stosifian/shoggoth-mini-bringup/media/mirror_demo.gif

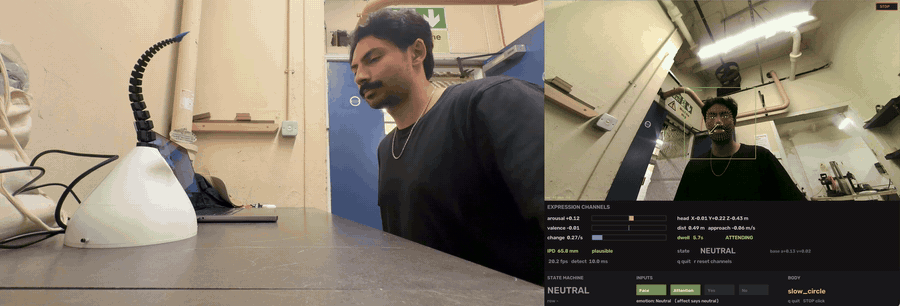
media/mirror_demo.gif
