stosifian/shoggoth-mini-bringup/assets/hardware/printing/roller_single_test.3mf

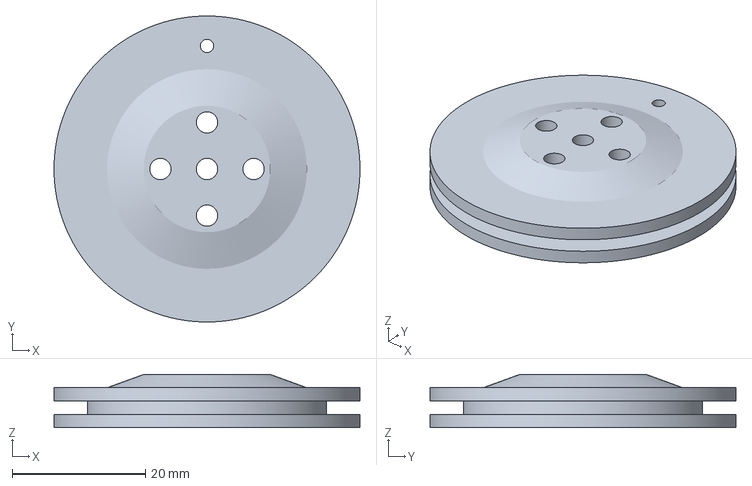
[picture p24: CAD file, 2026-08-24]
assets/hardware/printing/roller_single_test.3mf
46.0 x 46.0 x 8.00 mm
