stosifian/shoggoth-mini-bringup/assets/hardware/printing/tips.3mf

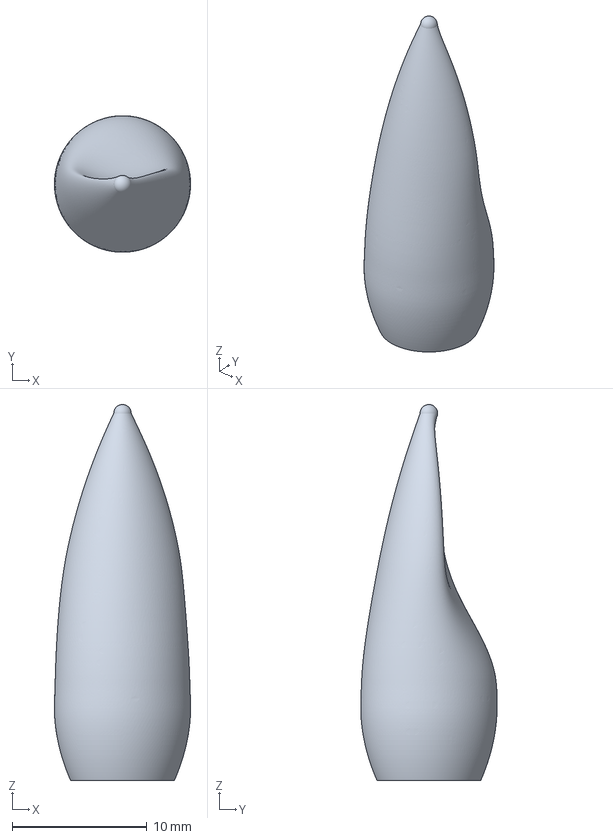
[picture p25: CAD file, 2026-08-24]
assets/hardware/printing/tips.3mf
10.1 x 10.1 x 27.9 mm
