stosifian/shoggoth-mini-bringup/assets/hardware/printing/dome_mod.step

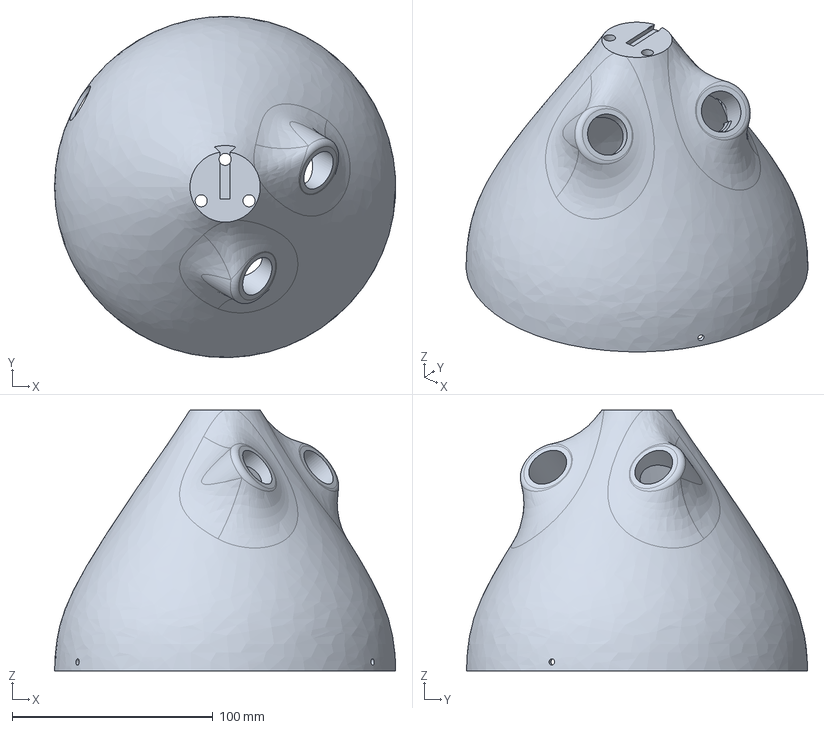
[picture p26: CAD file, 2026-08-24]
assets/hardware/printing/dome_mod.step
169.9 x 169.9 x 130.0 mm
