stosifian/shoggoth-mini-bringup/assets/hardware/printing/dome_mod_test.3mf

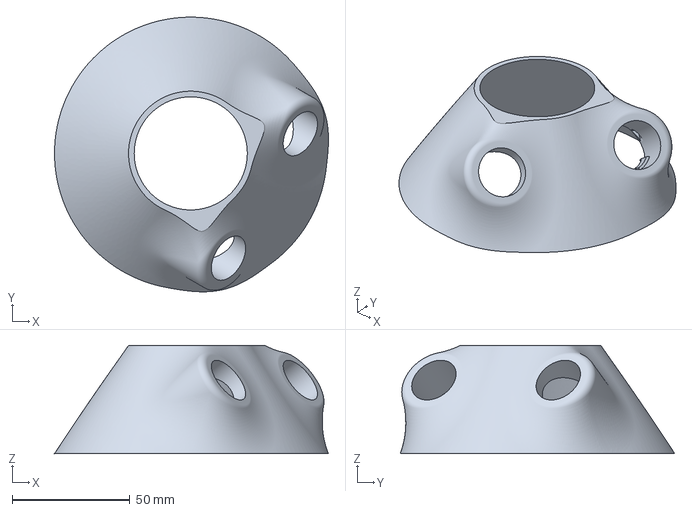
[picture p27: CAD file, 2026-08-24]
assets/hardware/printing/dome_mod_test.3mf
116.3 x 116.6 x 46.0 mm
