stosifian/shoggoth-mini-bringup/assets/hardware/printing/roller_cover_roller_tip_all.3mf

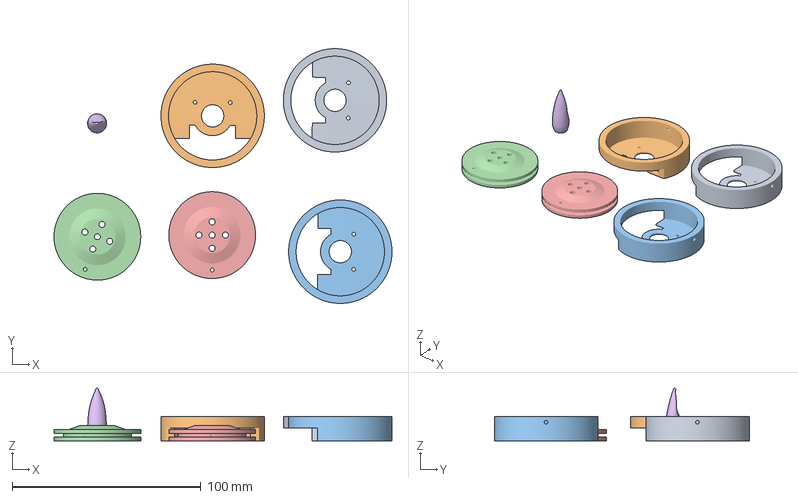
[picture p28: CAD file, 2026-08-24]
assets/hardware/printing/roller_cover_roller_tip_all.3mf
179.2 x 135.0 x 27.9 mm
roller_cover.step x 3
roller.step x 2
spike.step
