stosifian/shoggoth-mini-bringup/assets/hardware/printing/roller_cover_single.3mf

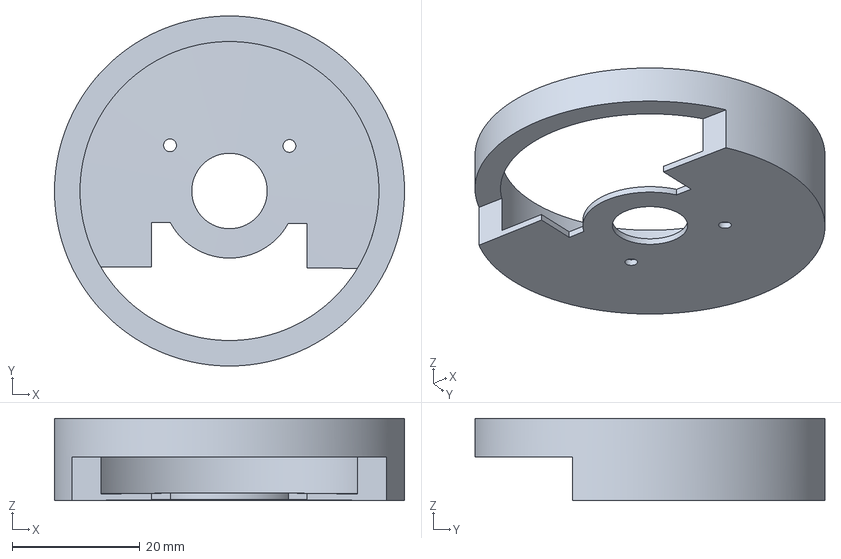
[picture p29: CAD file, 2026-08-24]
assets/hardware/printing/roller_cover_single.3mf
54.8 x 54.8 x 12.8 mm
