stosifian/shoggoth-mini-bringup/assets/hardware/printing/roller_cover_dual.3mf

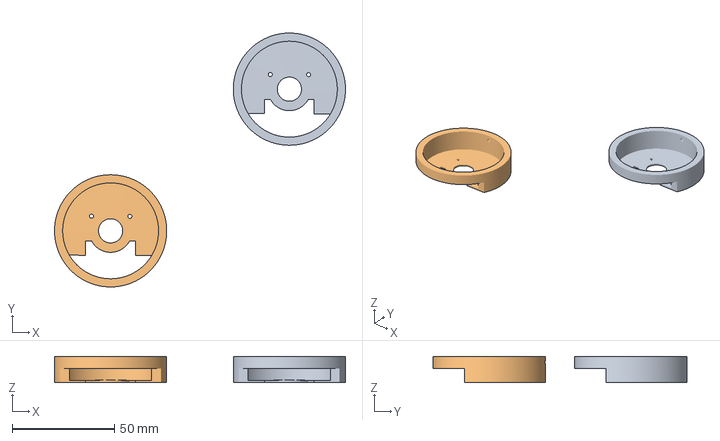
[picture p30: CAD file, 2026-08-24]
assets/hardware/printing/roller_cover_dual.3mf
142.1 x 124.0 x 12.8 mm
roller_cover.step x 2
