stosifian/shoggoth-mini-bringup/assets/hardware/printing/plate.3mf

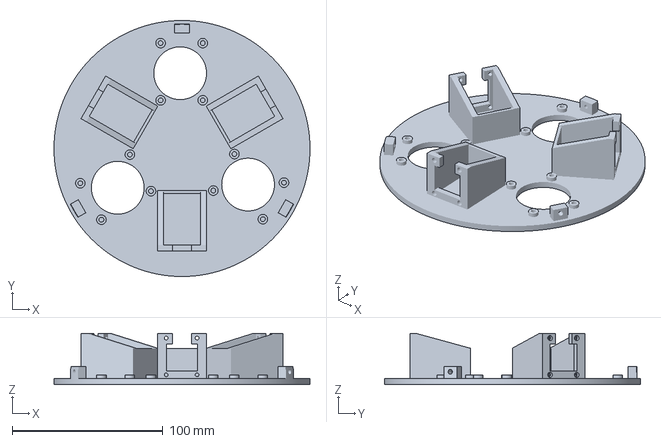
[picture p31: CAD file, 2026-08-24]
assets/hardware/printing/plate.3mf
170.0 x 170.0 x 34.0 mm
