stosifian/shoggoth-mini-bringup/(list of files, cad)

Other CAD files:
assets/hardware/printing/dome.3mf
assets/hardware/printing/dome_mod.3mf
