stosifian/shoggoth-mini-bringup/(commit log)

2026-08-24 chore: isolate from upstream and exclude local artifacts
    This repository is a derivative of mlecauchois/shoggoth-mini. The clone pointed
    at that repository as `origin` for both fetch and push; it is now `upstream`,
    fetch-only, with an intentionally invalid push URL so a stray push fails loudly
    rather than reaching for someone else's repo.
    Excluded from version control, with reasons:
    .venv/, __pycache__ environment
    results/ 210 MB PPO checkpoints; the trained policy that the robot
    actually uses is tracked under assets/models/
    data/ 55 MB raw checkerboard captures; the derived calibration
    is tracked, the c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
2026-08-24 fix(hardware): serialise bus access, coerce reads, refuse out-of-range targets
    Three changes to MotorController, each in response to a failure observed on
    hardware. Deliberately the only three deviations in this file, each marked
    "KEPT CHANGE n of 3" in place so the diff against upstream stays auditable.
    1. Serialise the bus behind an RLock. One half-duplex serial bus has three
    concurrent writers — the idle thread, primitives dispatched from the
    orchestrator's async handler, and the closed-loop controller. Nothing
    ordered them, which produced "[TxRxResult] Port is in use!" and killed the
    idle thread with an unhandled exception. RLock because set_positions nests
    into set_pos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
    [motors.py]
2026-08-24 fix(hardware): enable torque after Mode writes, validate calibration in range
    Two calibration failures with the same shape: something silently accepted, and
    the consequence surfacing much later as destroyed hardware.
    Torque interlock. Writing the Mode register resets Torque_Enable to 0 on the
    STS3215. The calibration routine set wheel mode and then commanded speed, so
    the motors were left with torque disabled: the tool printed "Turning 1" and the
    motors sat silent with no error anywhere. Torque is now enabled AFTER the Mode
    write and after Goal_Speed is zeroed, so enabling it cannot lurch the tendons.
    Calibration range. validate_calibration checked MOTOR_POSITION_MIN..MAX, the
    raw 16-bit r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
    [calibration.py, motor_calibration.py]
2026-08-24 fix(control): size the grab primitive for retension headroom
    Upstream grabs at cursor magnitude 0.7, a single unramped command of +2867
    ticks on motor 2 — 77 mm of cable in one move at ~200 mm/s — while motors 1
    and 3 each pay out 38.5 mm simultaneously. From a mid-range zero it targets
    4915, past the encoder fold, which is what tore a tendon off its roller.
    Set to 0.41, sized for retension headroom rather than depth. Grab winds motor 2
    in further than any other motion, so it is the first thing to run out of range
    when the calibrated zero moves — and the zero only ever moves up, because
    retension is always wind-in to take up slack. Measured with
    char_primitive_sweep.py --calib-offset: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
    [primitives.py]
2026-08-24 fix(perception): rectification in triangulation, camera orientation, velocity gate
    Stereo scale error. triangulate_points used the rectified projection matrices
    P1/P2 without the corresponding rectification rotations R1/R2 in
    undistortPoints. Mixing rectified projection with unrectified rays gave a
    metric scale error of ~11% — invisible to reprojection error, which is
    scale-invariant, so calibration reported RMS 0.4 px throughout. StereoCalibration
    now carries R1/R2 and passes them through; the scale error measures +0.1% after.
    Camera orientation. The camera is mounted inverted, so the world arrives upside
    down. Handling that with a 180-degree rotation of the composite stereo frame
    swaps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
    [default_perception.yaml]
2026-08-24 feat(tools): servo characterisation harness
    A measurement series built after several guards were added on assumptions about
    these servos that turned out to be wrong, two of which created new failure
    modes. The point is to establish the command/response space so limits can be
    derived rather than guessed.
    char_a2_wheelmode.py Present_Position semantics under powered rotation
    char_b_speed.py what Goal_Speed actually encodes
    char_c_step.py position-mode step response, both signs
    char_de_boundary.py behaviour at and beyond the 0..4095 boundary
    char_bus_writes.py how often a write silently fails to take effect
    char_primitive_sweep.py every designed motion, sta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
    [camera_sanity.py, char_a2_wheelmode.py, char_a_readonly.py, char_b_speed.py, char_bus_writes.py, char_c_step.py, char_cable_scale.py, char_common.py]
2026-08-24 feat(control): closed-loop telemetry
    Per-iteration CSV logging for the finger-tracking loop: cursor, targets, both
    per-eye detection flags, gate decisions and achieved positions, plus --dump-misses
    for the frames where a detection was expected and absent.
    Added because the loop's behaviour was being judged by watching the robot, which
    cannot distinguish a perception dropout from a control problem from a servo that
    ignored a command. Per-eye flags matter because detection rates multiply: two
    eyes at 80% give 64% of frames usable for triangulation, and the composite rate
    alone hides which eye is failing.
    [closed_loop.py]
2026-08-24 fix(orchestrator): migrate OpenAI Realtime from beta to GA
    The beta Realtime interface was retired, so the orchestrator could no longer
    connect. Changes required by the GA schema:
    * model endpoint gpt-4o-realtime-preview-2024-12-17 -> gpt-realtime
    * the `OpenAI-Beta: realtime=v1` header is gone; Bearer auth only
    * session.update now needs an explicit type: "realtime"
    * `modalities` renamed to `output_modalities`
    * turn detection moved from top-level to audio.input.turn_detection
    Validated end to end with live microphone input.
    [orchestrator.py]
2026-08-24 chore(config): this build's hardware config and vision fine-tuning setup
    Serial port for this machine, plus the setup for fine-tuning the tip detector on
    real captures. The synthetic-trained model overfits to a single background: tip
    detection drops out when a human face is behind the tip, since skin tones and
    curved high-contrast edges are absent from the synthetic training set.
    record_data.py gains the capture path for that, and finetune_real_vision.yaml
    documents the input/output collision to avoid when pointing it at a dataset.
    [default_hardware.yaml]
2026-08-24 assets: dome redesign and roller print sources
    The stock dome puts structure in front of the stereo camera. dome_mod.step is
    the reworked version with the interference removed; the .3mf files are the
    arranged plates for the parts printed for this build, including roller covers
    and the cut-section test pieces used to check clearances before committing to a
    full print.
    Sliced .gcode.3mf output is deliberately not tracked: it is specific to one
    printer and filament profile, and runs to tens of megabytes.
    [dome.3mf, dome_mod.3mf, dome_mod.step, dome_mod_test.3mf, plate.3mf, roller_cover_dual.3mf, roller_cover_roller_tip_all.3mf, roller_cover_single.3mf]
2026-08-24 docs: build writeup and attribution
    WRITEUP.md is the account of building and bringing up a physical unit: the dome
    redesign, tendon threading and roller assembly, motor calibration, stereo
    calibration and the camera-robot transform, finger tracking, and the open issues
    that remain.
    README.md gains an attribution header making clear this is a derivative of
    mlecauchois/shoggoth-mini used under MIT, and is not affiliated with or endorsed
    by the original author. The original README follows unmodified beneath it; the
    LICENSE and its copyright notice are untouched.
    media/ carries only the eight files the writeup references.
2026-08-25 docs: update writeup — copyedits, figure captions, two new figures
    Brings the repository copy in line with the working draft: copyediting
    throughout, captions added under each figure, and two figures that were
    referenced but not yet present — media/diagram.png and
    media/robot_camera_coordinates.png.
    The Credits section is now the author's own version, listing the original
    project alongside the ELEGNT and SpiRobs papers. Attribution and the MIT
    derivative notice live in the README header.
2026-08-25 docs: make the build writeup the front page
    GitHub always renders README.md and offers no way to point it elsewhere, so the
    writeup becomes README.md and the original project's README moves to
    UPSTREAM_README.md, where it keeps the install and quick-start instructions.
    The author's file is restored byte-for-byte to what upstream ships; the
    attribution blockquote that had been prepended to it now sits at the top of the
    new README, above the writeup, and points at UPSTREAM_README.md for setup.
    UPSTREAM_README.md gains a single italic line so anyone landing there directly
    knows which document they are reading.
    Note that .../blob/main/WRITEUP.md no longer resolves. The v1.0 tag still points
    at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
2026-08-25 feat(tools): per-tendon pull check
    Winds each motor in on its own and watches Present_Load, to tell a tendon that
    is transmitting force from one that is slack or whose horn is slipping on the
    spline. During a sweep all three move together, so a dead tendon is masked —
    the other two still bend the tentacle, just not where you asked.
    Present_Load is decoded as sign-magnitude (bit 10 is direction), without which
    an idle motor reads ~1070 rather than ~45.
    Caveat found in use: on a TPU 90A tentacle the forces are low enough that
    21 mm of wind-in raised load by only ~40 counts out of 1023, so the load signal
    does not cleanly separate taut from slightly slack on this build. Tip
    displacement per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
    [tendon_pull_check.py]
2026-08-26 feat(control): add slow_circle; remove two unguarded legacy probes
    slow_circle is a circle timed to what the servos can actually deliver. The stock
    circle exceeds the measured ~7600 ticks/s ceiling on 63 of its 81 commands, with
    entry and exit spikes near 30,000 — it slams onto the circle from neutral, runs
    round faster than the servo can track, and drops straight back to centre. Its
    traced shape is therefore set by servo dynamics rather than by its waypoints,
    which is why tuning its radius or point count does less than it appears to.
    slow_circle keeps the same radius and amplitude (+/-286 ticks on every motor)
    but triples the point count, dwells 20 ms per point, and spirals in and out
    ra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
2026-09-02 fix(control): keep every command inside the encoder range
    Enforce max_2d_action_magnitude on the live path (closed_loop.execute_action).
    It previously applied only in RL training and in
    convert_2d_cursor_to_target_lengths, so nothing bounded the policy's output on
    the live path: trained with an action space of +/-1.0 per component, it can emit
    magnitude ~1.41, which converts to targets set_position refuses, and the
    exception propagates out of the control loop and stops tracking.
    Clamp the cursor MAGNITUDE rather than per-motor ticks. Scaling the cursor
    scales all three motors together, so the commanded direction is preserved
    exactly and only reach shortens; clamping ticks moves one tendon w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
    [check_limits.py, closed_loop.py, default_control.yaml, motors.py]
2026-09-02 fix(control): survive transient bus failures instead of stopping
    Roughly 3% of position writes were measured to fail silently on this bus
    (2026-08-18), so a transient failure is expected rather than exceptional. Every
    motion loop treated one as fatal.
    closed_loop now skips the frame and counts consecutive failures, aborting only
    at 200. Deliberately not retried: the next frame computes a fresh action from
    fresh perception, which beats re-issuing a stale one.
    idle catches per-frame and rolls back _current_motor_positions, which the step
    limiter had already advanced -- leaving it advanced would make the loop believe
    it had moved and compound the error next frame. It runs in a thread, so an
    e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
    [closed_loop.py, default_orchestrator.yaml, idle.py, orchestrator.py]
2026-09-02 feat(control): add wave_packet_am, wave_packet_fm, slow_breathe
    Three expressive primitives, all sized to what the servos can actually deliver
    rather than to what the waypoints ask for.
    wave_packet_am Gaussian-enveloped spiral: the cursor rotates while the
    envelope scales its radius, so amplitude swells and decays.
    The envelope is ~0 at both ends, so position is continuous
    there and no entry ease is needed.
    wave_packet_fm constant radius, varying angular rate -- slow, accelerating
    to a peak, then slowing. Because the radius is constant this
    one does need an ease at each end.
    slow_breathe low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
2026-09-02 chore: face-perception plotter, and ignore model weights + recordings
    tools/plot_face_csv.py plots the telemetry written by the face perception bench:
    detection and IPD, head position, head pose with nod/shake detection, and the
    derived 5-state affect classification. It exists to answer whether the derived
    channels carry usable signal before any of them is allowed to drive a servo,
    which is not a question a spreadsheet answers.
    IPD is the panel that matters. Interpupillary distance is fixed on a real face,
    so every wobble in that trace is measurement error in the same units as the head
    position above it -- a trace wandering by 10 mm means the position is worth
    about that much too, however s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
    [plot_face_csv.py]
2026-09-02 feat(tools): fsm_check — verify the mirror state machine tables
    Reads the States/Timing/Transitions/Inputs CSVs as the source of truth and runs
    four passes:
    STATIC every symbol resolves — conditions naming undeclared inputs,
    transitions to states that do not exist, states with no timing
    row. These look fine in a spreadsheet and fail on execution.
    DETERMINISM for every (state, input) pair, how many transitions fire. Two at
    the same priority means behaviour depends on row order in a CSV.
    This is the pass that cannot be done by eye, because the clashes
    live in combinations nobody pictures.
    REACHABILITY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
    [fsm_check.py]
2026-09-02 fix: no face means no emotion asserted, not neutral
    AffectState reported "neutral" whenever it had no face to look at, and the
    checker's input space encoded the same thing. But neutral is a claim about a
    face that WAS looked at, and collapsing the two makes an absence
    indistinguishable from a calm person. Downstream that was a real defect: a
    transition reading "Neutral == 1" fired when the person left the room, which
    showed up as a genuine clash between ENGAGED -> NEUTRAL and the -> ALONE
    fallback.
    No face now yields 'unknown', which in the state machine's terms is all five
    emotion inputs at 0 rather than a sixth value. The FSM sees an absence of
    evidence, not evidence of calm.
    face_prob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
    [Inputs-Inputs for Shoggoth-Mirror.csv, States-State Table for Shoggoth-Mirror.csv, Timing-Timing Table for Shoggoth-Mirror.csv, Transitions-Transition Table for Shoggoth-Mirror.csv]
2026-09-03 feat(tools): plot the take's own affect labels, shadow the recomputed ones
    The plotter recomputed affect from arousal/valence using the whole take's
    median, while the state machine consumed the LIVE labels computed from a
    running median that could only see the past. On one real recording the two
    agree on 75% of frames, so a transition could look unmotivated on the plot for
    reasons that were entirely an artefact of the plot.
    Panel 4 now shades by the take's own `state` column when it has one -- those
    are the labels the robot acted on. The recomputed classification is drawn as a
    thin shadow ribbon underneath with the agreement percentage, so the divergence
    is visible rather than hidden; it is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
    [Transitions-Transition Table for Shoggoth-Mirror.csv]
2026-09-03 test(tools): affect_golden — pin every affect quantity for refactor checks
    Runs the whole affect stack over the two test takes and records exact results:
    classification labels (batch and streaming), baselines, gesture spans, rolling
    noise, attention, head geometry, and the full FSM trace and transition log.
    Arrays are stored as digests so a diff is one line rather than thousands.
    Written to answer one question -- did a change alter behaviour -- which is the
    question a refactor should be judged on. It pins behaviour, not correctness: if
    something is wrong today the golden faithfully preserves the wrongness.
    [affect_golden.py]
2026-09-03 chore: track exploration/ — it stopped being scratch
    exploration/ was ignored as "scratch tooling for a future form factor". That
    description no longer fits: face_probe.py holds the live affect estimation the
    mirror state machine consumes, and it was the authoritative implementation of
    logic that plot_face_csv and fsm_check both depend on -- sitting untracked,
    with no recovery if it were lost.
    Tracks the seven sources and the motion-space notes. Generated output stays
    ignored: exploration/out/ holds session recordings derived from camera footage,
    and exploration/assets/ is regenerated by tentacle_variants.py in one command.
    [face_probe.py]
2026-09-03 refactor(tools): move face_probe out of exploration/, unchanged
    Byte-identical move. PKG = HERE.parent resolves to the same directory from
    tools/ as it did from exploration/, so no edit was needed. Separated from the
    library extraction that follows so the move is reviewable on its own.
    affect_golden reports IDENTICAL across both test takes.
    [face_probe.py]
2026-09-03 docs: known issues found during the affect extraction, left unfixed
    Three, all found while moving code and deliberately not fixed: a refactor that
    also changes behaviour cannot prove it changed nothing.
    The one that matters is that a frame with a face but NaN affect is labelled
    'sad' on the live path and 'unknown' on the batch path. NaN fails every
    comparison, so it escapes the neutral radius test and lands in the (False,
    False) quadrant -- the robot would mirror sadness at someone whose expression
    it could not read. The fix belongs inside quadrant() rather than in either
    caller, so no future driver can reintroduce it.
    Also records that the golden harness was itself validated: the current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
2026-09-03 fix(affect): a face with unreadable affect is 'unknown', not 'sad'
    AffectState branched only on have_face while classify_affect also tested
    isfinite, so a frame where the detector found a face but the blendshape values
    were NaN took different paths: 'sad' live, 'unknown' batch.
    'sad' because NaN fails every comparison. hypot(nan, nan) < bar is False, so it
    escaped the neutral radius test; then da > a_thresh and dv > v_thresh are both
    False, and (False, False) is the sad quadrant. The robot would have mirrored
    sadness at someone whose expression it could not read.
    The guard goes inside quadrant() rather than into either caller, because it is
    a precondition of the rule and not of either driv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
2026-09-03 feat(tools): parse audit and a diagram generated from the parsed table
    Two answers to 'is the CSV -> state machine conversion trustworthy'.
    The parser is a regex over free text, deterministic but silently lossy: it takes
    what it recognises and drops the rest without complaint. Most malformed input
    fails loudly -- >= and != land as UNPARSED, an undeclared input is caught by the
    static pass -- but OR does not. 'A == 1 or B == 1' parses as 'A == 1', because
    the split knows only & and 'and' and _TERM.search returns the first match in a
    clause. Such a row would be checked, drawn and executed as something narrower
    than written, with nothing saying so.
    audit_condition now strips the terms and dur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
    [fsm_check.py]
2026-09-03 fix(tools): restore Roi, lost in the affect extraction
    The library extraction removed head_angles, affect_from_blend and AffectState
    from face_probe by cutting text between named anchors. class Roi sits between
    head_angles and detect_face in the file, so it went with them -- face_probe then
    raised NameError on its first frame.
    Three checks failed to catch this, each for a different reason worth recording:
    py_compile passed, because a missing name is a runtime error not a syntax one.
    affect_golden reported IDENTICAL, because it exercises the classification
    math and never constructs an Roi -- it proves the numbers did not move, which
    is what it is for, and says nothing about whether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
    [face_probe.py]
2026-09-03 refactor(affect): the state machine moves to the library
    The machine was implemented once, but it lived inside tools/fsm_check.py. Fine
    while the only consumer was a checker; wrong the moment a robot needs it, since
    tools/ is not a package and importing a runtime state machine from a debugging
    CLI is backwards -- the same shape as fsm_check previously importing gesture
    detection from a plotting tool.
    shoggoth_mini/affect/fsm.py now owns the parsing, the input space, the condition
    evaluation, the mermaid emitter and the stepping. tools/fsm_check.py keeps only
    what it is for: the checks, the plots, and decoding a recording into inputs.
    One design change was needed rather than a pure move. re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
    [fsm_check.py]
2026-09-03 feat(control): normal_breathe — the same breath at double frequency
    NOTICING needs a body: present but not yet attended to, so a touch more alive
    than ALONE without being a reaction. That is slow_breathe with period_s 2.0
    instead of 4.0.
    A config variant rather than a second primitive, so the shape, the easing and
    the deadzone workaround stay defined once. Peak rate scales with 1/period:
    1100 ticks/s, about 14% of the measured 7600 ticks/s ceiling.
    char_primitive_sweep --dry-run: 502 commands, max step 22 ticks, 18.8 mm of
    cable travel, implied 1084 ticks/s, range ok. Registered with the sweep, the
    prim runner and the orchestrator's primitive list.
    [States-State Table for Shoggoth-Mirror.csv, Timing-Timing Table for Shoggoth-Mirror.csv, Transitions-Transition Table for Shoggoth-Mirror.csv]
2026-09-03 refactor(perception): face landmarks move into the package
    detect_face, Roi, FaceObs and the thread-local detector were in tools/face_probe,
    which meant the orchestrator would have had to import its perception from a
    debugging viewer -- the third time this inversion has come up, after gesture
    detection living in a plotting tool and the state machine living in a checker.
    They belong in perception/ beside hand_tracking.py: same MediaPipe Tasks API,
    same thread-local detector for the same reason (not thread safe, two eyes
    processed concurrently). This layer answers where the face is and what it is
    doing; affect/ decides what that means.
    tools/face_probe.py is now viewer and recorder only -- C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
2026-09-03 feat(orchestrator): orchestrate_mirror — the robot acting on the state machine
    Perception -> state -> motion, with no model anywhere in it. Distinct from the
    author's `orchestrate`, which is an LLM in a voice loop calling primitives as
    tools. Voice is deferred to v1.1.
    python -m shoggoth_mini orchestrate-mirror # motors OFF
    python -m shoggoth_mini orchestrate-mirror --motors --csv session.csv
    MOTORS ARE OFF BY DEFAULT. The whole loop, the machine and the logging run
    without touching the bus, which is the mode to develop in: watch it react to a
    real person with nothing able to move.
    Perception runs on the main thread and never blocks; motion runs on its own with
    a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
2026-09-03 fix(affect): Channels lost its affect_from_blend import when it moved
    Channels.update returns early when there is no face, so it only reaches
    affect_from_blend once a detection exists. Every fixture in this repo is either
    an empty room or a synthetic video of grey circles, so the branch was never
    executed and the missing import survived a refactor, a golden comparison and an
    end-to-end run before failing on the first real face.
    That is the second bug hidden the same way -- class Roi went the same route --
    so the fix is structural as well as literal. affect_golden now drives Channels
    with a synthetic FaceObs and pins the resulting arousal, valence, dwell and
    distance, so the face-present pat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
    [affect_golden.py]
2026-09-04 tables: affect states reachable from each other, via four generic rows
    The first live session found the affect half of the machine could not follow a
    person. Angry affect held for 3.39, 2.13 and 1.7 seconds -- all past the 1.5 s
    requirement -- and ANGRY still never fired, because those runs happened while the
    machine sat in SAD and no SAD -> ANGRY row existed. The affect states were pure
    hub-and-spoke around NEUTRAL, so 13 of the 20 affect changes the person actually
    made had no row to take, and SAD absorbed 16 seconds during which the affect was
    'angry' for 255 frames and 'sad' for 97.
    Four 'Any except ..., <target>' rows replace the four NEUTRAL -> <affect> ones.
    Excluding the target from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
    [Transitions-Transition Table for Shoggoth-Mirror.csv]
2026-09-04 fix(affect): hysteresis on the sign tests, not just the radius
    The deadband was a Schmitt trigger on the RADIUS only. Once outside the circle
    the quadrant came from two bare sign comparisons, so a point parked on an axis
    relabelled itself on noise indefinitely. Measured across a 96 s session: 17 of
    28 label changes crossed a quadrant boundary rather than the deadband, twelve of
    them sad<->angry, with |d_arousal| under 0.02 on 28% of frames outside the
    circle. Arousal is the axis this bites, because it is built from additions to a
    neutral face and so rarely goes negative.
    quadrant() now carries a Latch of three bits instead of one bool: whether we
    were inside the deadband, and which side of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
2026-09-04 fix(control): no's lead-in asked for twice the servo ceiling
    NoMotionConfig.initial_delay is the sleep AFTER the first set_positions, so it
    is the time that step has to complete in, not a pause before starting. At 0.05
    it asked 839 ticks in 50 ms -- about 16,800 ticks/s against a measured ceiling
    of ~7,600. Past the ceiling the move is still in flight when the next command
    lands, so the traced shape comes from servo dynamics rather than from the
    waypoints, which is the defect slow_circle was reworked for.
    Nothing about the primitive changed; what changed is that it is about to be used
    constantly. As an LLM-invoked primitive it fired occasionally, but as the NO
    state's body it plays on every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
    [Transitions-Transition Table for Shoggoth-Mirror.csv]
2026-09-04 fix(orchestrator): load the hardware config, do not build defaults
    orchestrate_mirror constructed MotorController() with no argument, which builds
    HardwareConfig() from pydantic defaults rather than reading
    default_hardware.yaml. The same trap as get_perception_config(None), and worse
    here:
    port default empty yaml /dev/tty.usbmodem5B610324221
    tick_sign default +1 yaml -1
    motor_settle_time default 0.5 yaml 0.01
    control_loop_hz default 50 yaml 200
    tick_sign inverted means every commanded direction is reversed. The range guards
    in MotorController would not have caught it, because the positions are perfectly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
    [mirror.py]
2026-09-04 fix(orchestrator): bind camera orientation to the config actually loaded
    camera.read_oriented resolves camera_rotate_180 by reading the DEFAULT
    perception YAML, whatever config the caller loaded. Pass --config with a
    different orientation and the frame rotation silently disagrees with the
    triangulation.
    That is not a cosmetic mismatch. camera.py's own docstring spells it out: a 180
    degree rotation swaps which half of the side-by-side frame belongs to which
    physical camera, so split_stereo_frame assigns left and right backwards, the
    stereo baseline inverts, and every 3-D estimate is geometrically wrong while
    still looking entirely plausible.
    set_camera_orientation exists precisely for this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
    [mirror.py]
2026-09-04 feat(control): derive grab depth from the live calibration, floor at 500 ticks
    Grab is the deepest reach in the set and the closest to the end stop: at the
    2026-09-04 zeros it commanded 4014 of 4095, 81 ticks from refusal. It is also
    the one whose margin shrinks unattended, because retension only ever winds the
    zeros UP and motor 2 -- the axis grab drives, alignment +1.0 -- has the least
    headroom of the three.
    A new literal would have been wrong for the same reason the old one was. 0.275
    gives exactly 101 ticks today and nothing tomorrow; you would be re-checking
    after every retension, which is what produced this. So the depth is now DERIVED:
    each motor caps the magnitude at (limit - zero)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
    [primitives.py]
2026-09-04 feat(tools): mirror_rehearsal — run the mirror's motion with tendons ATTACHED
    char_primitive_sweep asks "is any designed motion dangerous" and requires the
    tendons detached to answer it. This asks the narrower question the bring-up
    actually needs -- "does the mirror machine's motion behave with the tendons on"
    -- and earns running attached by being conservative.
    It drives MotionWorker with the same BodyAction objects orchestrate_mirror
    posts, so grab's hold-and-release, the looping of sustained bodies and the
    one-shot gestures are exercised as they run rather than as a list of primitives
    called in sequence. Bodies come from the States table, so remapping a state
    follows automatically. Sta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
2026-09-04 feat(control): arched — a held posture for SAD and ANGRY, replacing grab
    Grab reaches as deep as the calibration allows and arrives in a single command:
    1127 ticks at 3691 ticks/s at today's zeros. That is a lunge. For a state whose
    point is a held posture it is the wrong shape, and it is the closest thing in
    the set to the encoder end stop.
    arched is the opposite. A FIXED 500 ticks along motor 2's axis, reached by a
    linear ramp over 1.5 s: 75 commands, 7 ticks a step, 348 ticks/s -- about 4% of
    the servo ceiling and ten times gentler than grab. Fixed rather than derived
    because at 500 ticks it sits 2495 clear of the range today and would still be
    clear after 2000 ticks of retension drift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
    [char_primitive_sweep.py, mirror.py, mirror_rehearsal.py, orchestrator.py, primitives.py]
2026-09-04 feat(control): side_side — a tick-tock sway for CONTENT and EXCITED
    Anticipation and overshoot, which is what makes a movement read as intended
    rather than merely executed. A raised-cosine sweep arrives at each extreme with
    zero velocity; a fast beat then punctuates that pause -- retreat 20% of the
    amplitude, overshoot 20% past it, at 3x the sweep's pace. The eye reads the
    CHANGE in speed more than the distance travelled, which is why a fifth of the
    sweep is legible as a flourish.
    Two things it gets right that the wave packets it replaces did not.
    LEFT-RIGHT, not fore-aft. direction_deg 60 is perpendicular to motor 2's axis,
    so motor 2 stays exactly still -- alignment 0.000, measured 0 t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
    [char_primitive_sweep.py, orchestrator.py, primitives.py]
2026-09-04 tune(control): arch depth 500 -> 700 ticks
    Deeper hold for SAD and ANGRY. 700 ticks is 18.8 mm of cable, the same travel
    as slow_breathe, reached over the same 1.5 s ramp: 467 ticks/s, about 6% of the
    servo ceiling, 10 ticks a step.
    Still fixed rather than derived. At 700 it sits 528 ticks clear of the encoder
    range at today's zeros and would remain clear after 500 ticks of retension
    drift; beyond that check_limits reports it before anything moves. Grab needed
    the derived cap because it reached as deep as the calibration allowed; a fixed
    pose well inside the range does not.
    check_limits: arched 2312..3567, margin 528, PASS.
    [primitives.py]
2026-09-04 refactor(control): side_side beats get independent speed multipliers
    speed_mult governed both halves of the flourish, so the only way to make the
    overshoot snap through the retreat was to change how durations were derived --
    a code change rather than a parameter. retreat_mult and overshoot_mult separate
    them: equal values give one continuous gesture at constant pace, a higher
    overshoot_mult makes the retreat a wind-up the overshoot cracks through.
    No behaviour change at the current values; both default to 3.0, which is what
    speed_mult was.
    [primitives.py]
2026-09-04 tune(control): side_side_fast sweep 1.8s -> 1.0s
    EXCITED at 0.357 Hz rather than 0.198 -- a full left-right round trip every
    2.8 s instead of 5.0. Play length drops to 5.6 s, which also halves the
    worst-case delay before a state change becomes visible, since a primitive
    cannot be interrupted.
    Everything else follows from sweep_s being a pure time scale: the beats are
    fractions of it, so they shrink with it. Peak rate 1077 -> 1916 ticks/s, still
    25% of the ceiling. Range margin unchanged at 348, since amplitude did not move.
    The cost is beat resolution. The retreat is now 7 command points and the
    overshoot 12, down from 13 and 22. Still above the ~5 where a tick stops reading
    as one, but th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
    [primitives.py]
2026-09-04 fix: bodies resolve by name, unarch ramps back, stop() joins before releasing
    Three defects, all surfaced by pointing the states at the new primitives and
    running the static pass.
    body_for guessed at the SHAPE of a primitive name -- a lowercase token
    containing an underscore, plus a hardcoded set of four short ones. `arched` has
    no underscore and was not in that set, so SAD and ANGRY resolved to no body at
    all and would have stood still with nothing reporting it. It now matches against
    MotionBehavior, which is the authority on what a primitive is, so a new one
    works here for free.
    arched ramped out over 1.5 s and release_object put it back in a SINGLE command:
    699 ticks in one step, whose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
    [States-State Table for Shoggoth-Mirror.csv]
2026-09-04 feat(control): primitives can be cut short, so the mirror reacts in ~0.5s
    A primitive is a blocking loop of set_positions and sleep with no way out, so a
    state change had to wait for the current play to finish. ALONE is slow_breathe
    at 24.6 s: someone could walk up and stand there for most of half a minute
    before the robot noticed, and Ctrl+C took just as long to stop the motion.
    execute_behavior now takes an optional should_stop callable, threaded down to
    the loops the mirror runs on repeat: both breaths and both sways. They check it
    between command points, so the granularity is one time_per_point, 20 ms.
    Bailing out is not enough on its own. Stopping mid-motion leaves the tentacle at
    an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
    [mirror.py, primitives.py]
2026-09-04 chore(control): slow_circle accepts should_stop (not yet honoured)
    Plumbing only, committed on its own so the diagnosis below has a clean base.
    The parameter is accepted and threaded through execute_behavior but nothing
    checks it yet; slow_circle behaves identically, 151 commands at 2184 ticks/s.
    From the first motorised session (exploration/out/motion_1.csv, 91.5 s, 13
    transitions) two defects are visible, both downstream of perception -- the
    machine entered YES at 79.52 s and NO at 85.08 s, so the gestures were detected
    correctly and the motion did not follow.
    1. slow_circle is the only body the mirror loops that ignores should_stop, so
    every transition OUT of NEUTRAL waits up to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
    [primitives.py]
2026-09-04 fix(control): slow_circle honours should_stop, and slow_breathe actually did not
    Two problems, one of them mine from the previous commit.
    slow_circle issues every command through a nested go() called from three loops,
    so a plain return would end one command and let the caller start the next leg.
    It now raises _Interrupted, eased back to neutral first, and the three loops are
    wrapped to catch it. Uninterrupted behaviour is unchanged: 151 commands through
    execute_behavior, same as before.
    slow_breathe was never interruptible. Its dispatch in execute_behavior is
    formatted on one line and my earlier replace, which matched a multi-line shape,
    silently missed it -- so ALONE, the longest play in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
    [mirror.py, mirror_rehearsal.py, primitives.py]
2026-09-04 fix(orchestrator): gestures get their own slot, so a nod cannot be discarded
    MotionWorker had one "latest wins" slot for everything, which conflates two
    different kinds of thing. A state describes how things ARE, so the newest one
    should replace the last. A gesture is an acknowledgement of something a person
    DID, and discarding it means the robot ignored them.
    The first motorised session showed the cost. YES was entered at 79.52 s and left
    at 80.12 s -- exactly its 600 ms min duration -- so post(YES) filled the slot and
    the post(NEUTRAL) that followed threw it away before the worker, then inside an
    uninterruptible slow_circle, had looked. The nod was detected, entered and
    exited without one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
    [mirror.py]
2026-09-04 feat(orchestrator): play the yes/no clips with their gestures
    BodyAction.sound has carried an unused field since v1 for exactly this, so
    nothing needed threading through the worker. body_for now fills it by looking
    for a clip named after the primitive in assets/audio -- yes.m4a with the nod,
    no.m4a with the shake. Adding a sound for another primitive is dropping a file
    in, with no table or code change; nothing else in the set has one, so nothing
    else plays.
    afplay rather than a library. pygame-ce is installed but its mixer cannot decode
    m4a ("Unrecognized audio format"), and afplay ships with macOS and decodes it
    natively. Converting the clips to wav would also work, but a subprocess that i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
2026-09-08 feat(mirror): live perception window alongside orchestrate-mirror
    --view opens a window showing the camera with landmarks, the expression
    channels, and a new strip for the state machine's own side: the state, the
    input bits that produced it, the row that fired, and the primitive playing.
    The window runs on the perception thread, which is the main thread -- cv2's
    pump is main-thread-only on macOS, and only the motors are on a worker, so
    this is the one place it is safe. Cost measured at real capture size (1920x760
    per eye): 5.8 ms/frame for one eye, 10.8 for both, against detection that runs
    40-500 ms. One eye is the default because two views of the same face tell a
    viewer nothing extra.
    Th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
2026-09-08 tools: jitter_probe, to apportion landmark wobble between model, crop and sensor
    "The landmarks jitter" does not say which of three things is moving, and each
    has a different fix. The probe freezes one frame and re-runs detection on it,
    which is the only way to separate them: identical pixels isolate the model,
    deliberately jogged crops measure the ROI, and live frames give all three.
    Reported in degrees of yaw/pitch rather than pixels, because degrees are what
    attending() and the gesture detector compare against a threshold.
    Motivated by a measurement on demo.csv (3094 frames, 155 s): the high-frequency
    residual after removing a 5-frame rolling median is 0.50 deg yaw and 0.56 deg
    pitch, a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
    [demo.csv]
2026-09-08 tools(jitter_probe): positive control, so test A's zero means something
    Test A reported yaw sd 0.000 and landmark sd 0.00 px on identical pixels. That
    is the expected result for a deterministic regressor, but it is also exactly
    what a broken harness reports -- one that hands back a constant, or appends the
    same aliased array N times. The number alone cannot tell the two apart.
    Three additions make it falsifiable:
    - a positive control that perturbs the frame by +/-1 LSB, below any visible
    change and far below sensor noise, and REQUIRES the output to move. If one
    bit of noise changes nothing, test A is measuring the harness.
    - full-precision printing, since %.3f renders 4e-4 as "0.000" a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
    [jitter_probe.py]
2026-09-08 tools(jitter_probe): drive test B from measured ROI motion, not a guess
    Test B jogged the crop by an assumed +/-2 px and +/-1 %. That assumption was
    never checked, and two consecutive runs disagreed by 9x on how much of the live
    pitch variance it explained (10% then 92%) -- because the effect scales with
    crop size, which differs every sitting. The apportionment was not reproducible,
    so it should not have been quoted.
    The live pass now runs first and records the box after every detection.
    detect_face calls roi.follow() in place, so reading roi.x0/y0/side back is the
    real production trajectory, with no instrumentation inside face.py that could
    alter what it measures. B then resamples those ac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
    [jitter_probe.py]
2026-09-08 fix(affect): Schmitt trigger on attending, and a golden that can see it
    attending() was a bare comparison and its own docstring predicted the failure:
    "it chatters at the boundary -- one noisy frame crossing the threshold resets a
    dwell timer that has been building for ten seconds. Callers that care want
    hysteresis." No caller ever added it.
    Measured on demo.csv (3094 frames, 155 s): the bit flipped 66 times, and 57 of
    61 flips landed within one degree of a threshold, median 0.28 deg. That is a
    head parked near the boundary being toggled by landmark noise, which
    jitter_probe puts at 0.4-0.7 deg sd on yaw and 0.7-0.9 on pitch.
    Input smoothing cannot fix this. A head sitting exactly on the t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
    [affect_golden.py, face_probe.py, mirror.py]
2026-09-08 tools(jitter_probe): capture real landmark sequences for offline ROI work
    Adds --save-landmarks, writing the live px arrays, poses and box trajectory to
    an npz so Roi.follow() can be modified and replayed without a camera.
    Written after an attempt to fix the ROI jitter was validated against SYNTHETIC
    landmarks and the validation turned out to be meaningless. A real face mesh has
    hundreds of points densely along the silhouette; the synthetic stand-in was a
    Gaussian blob with two corner points, so a 1% trim deleted exactly the points
    defining the extent and the box collapsed. The measurements said the fix did
    not work, when what they actually measured was the fixture.
    Same failure mode as th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
    [jitter_probe.py]
2026-09-08 fix(perception): quantise the ROI size so a still face gets a still crop
    The crop feeds a deterministic but extremely sensitive regressor -- one LSB of
    pixel noise moves pitch by ~0.2 deg -- and jitter_probe measured the box
    stepping ~1 px on EVERY frame with the subject holding still. That accounted
    for ~61% of live yaw variance, reproduced across two sittings.
    The cause was not where I first looked. Replaying 896 recorded frames of a real
    face:
    centre from the landmarks 0.23 px per frame (already steady)
    side 2.08 px per frame (ROI_MARGIN multiplies a
    0.43% extent wobble by 2.2)
    x0 = centre - side/2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
    [jitter_probe.py]
2026-09-08 exploration: micro-icons for the system diagram
    The perception path's design -- running baseline, deadband, Schmitt triggers --
    was invisible in the diagram, and spelling it out in text would have crowded
    the one part that is already dense. These are the standard transfer-function
    glyphs for each mechanism, which a reader parses without a caption:
    schmitt two transitions with direction arrows: enter and leave differ
    deadband flat zone about the origin, output ignores small input
    baseline signal against its slow median, difference shaded
    circumplex four quadrants with a dashed neutral disc at the origin
    quantised staircase against a smooth ramp (the ROI size rule)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
    [demo.csv]
2026-09-08 exploration(icons): raise raster resolution and fold the contact sheet in
    Icons now render at 400 dpi (~800-960 px rather than ~320), which is the
    headroom a 48 px placement needs once a diagram is exported at retina scale or
    printed. The SVGs were already resolution-free and remain what should actually
    go in the diagram; the PNGs are for tools that will not take vector input.
    The contact sheet moves out of an ad-hoc script and into the generator, at 300
    dpi (3491x1583). It renders from the SAVED PNGs rather than redrawing, so what
    is being judged is the artefact that ships, and it shows every glyph at 64 and
    40 px as well as full size -- the small columns are the point, since that is
    what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
2026-09-08 exploration(icons): monochrome by default
    The diagram encodes DATA TYPE in hue -- teal sensor, blue binary, orange
    discrete, magenta continuous. These glyphs describe OPERATIONS (hysteresis,
    subtraction, quantisation), which are not a data type, so any hue they carry
    asserts a category that does not exist and competes with the scheme.
    The circumplex was the offender: four coloured quadrants implied four data
    types, and two of its hues collided with the blue and orange already in use.
    Quadrants are now grey tints, which keeps them distinguishable without claiming
    anything about them.
    Emphasis moves from colour to line weight and dash, so nothing is lost where
    the accent used to do the work.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
2026-09-09 exploration(icons): passband glyph for the gesture rate test
    Sixth glyph, for the 0.8-4 Hz band in detect_head_gestures -- the test that
    separates a shake from someone slowly turning to look at something, since both
    swing far and only one swings repeatedly.
    Drawn with hard shoulders rather than a roll-off, because nothing is actually
    filtered: the hysteretic half-cycle rate is computed and compared against the
    band. A gentle skirt would imply an attenuation that does not exist. The glyph
    is an abstraction of "only oscillation in this band counts", and the square
    shape keeps it from over-claiming.
    Pairs with the existing schmitt glyph on the Head Gesture box -- those two
    cover the distincti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
2026-09-09 exploration(icons): clip/saturation glyph for the affect math
    Seventh glyph, for the final stage of affect_from_blend:
    clip( sum(b_i * w_i) / sum|w_i| * 3.0, -1, +1 )
    Dual of the deadband glyph -- that one is flat in the middle, this is flat at
    the ends -- so the two read as a set.
    The slope is drawn steep, reaching the rail at about a third of the input
    range, because that is the honest shape of this stage rather than a generic
    saturation curve. Gain is 3.0 against already-normalised inputs, so a broad
    smile (mouthSmile ~0.9) lands on valence +1.00 exactly and every stronger
    expression maps to the same value. A gentle 45-degree slope would depict a clip
    that rarely fires; this one fi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
2026-09-09 exploration: breathe comparison plot on a shared time axis
    slow_breathe and normal_breathe are the same primitive at different periods --
    NORMAL_BREATHE_CONFIG is SlowBreatheConfig(period_s=2.0) and nothing else
    changes. Plotted on separate axes they look identical, because each fills its
    panel with the same six cycles; only a common x axis shows that one is twice
    the rate. That misreading is the whole reason for the figure.
    Captured through RecordingController, the harness char_primitive_sweep uses, so
    these are the command streams execute_behavior actually sends rather than a
    re-derivation of the sinusoid.
    Motor 2 is drawn bold because it carries the breath; 1 and 3 pay out half each
    and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
2026-09-09 exploration(breathe plot): clip to the shorter run, and count cycles correctly
    Clipping to the LONGER run left the top panel empty past 12 s, and empty space
    is not evidence. The comparison is a rate, so the strongest frame is the window
    where both are running and the reader counts 6 cycles against 3.
    Also fixes the cycle labels, which floored 5.95 to "5 cycles" and 2.97 to "2"
    while the figure plainly showed six and three. A caption that contradicts its
    own plot is worse than no caption.
2026-09-09 exploration: generalise the paired-primitive plot, add side_side
    Replaces plot_breathe_compare.py with plot_pair_compare.py, which emits both
    figures from one implementation. Both pairs make the same claim -- identical
    shape, different setting -- so they should be argued the same way rather than
    by two scripts that can drift.
    side_side leads with motors 1 and 3 and draws motor 2 faint on purpose: the
    sway runs along the 60 degree axis, which is perpendicular to motor 2, so it
    travels EXACTLY 0 ticks while 1 and 3 mirror each other. That flat grey line is
    the left/right-versus-nod point made visually, and it is the defect the first
    version of this primitive had when the axis was copied from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
2026-09-09 exploration: animated spectrograms of the yes/no clips
    GIF rather than an <audio> tag or an mp4, for a boring but decisive reason:
    GitHub strips <audio> from repo markdown, and inline video wants a
    user-attachments URL rather than a relative path. A GIF is just an image, so it
    renders wherever the other figures do.
    Animated because the claim is about a CONTOUR -- rising pitch reads
    affirmative, falling reads negative -- and a static spectrogram makes the
    reader trace that themselves. Both clips share one figure and one clock, so the
    rise and the fall are directly comparable instead of being two pictures at two
    scales.
    The measurement backs the design: "yes" climbs 0.2 -> 2.1 kHz, "no" star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
2026-09-10 writeup: demo gifs for the noticing transition and the yes/no gestures
    Three clips cut from the side-by-side composite, each showing the robot and the
    perception readout together so a reader can see the state machine's own view of
    what it did:
    noticing.gif 0:11-0:20 ALONE -> NOTICING: slow_breathe to nobody, face
    acquired, body switches to normal_breathe. The Face
    input lights while Attention stays dark, which is
    the distinction NOTICING exists to encode.
    no.gif 1:31-1:35 shake detected, NO entered, "no" primitive played,
    back to slow_circle, all inside four seconds.
    y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
2026-09-10 readme: point at Part 2
    The repo root was Part 1 only, so anyone landing here from a shared link saw
    the build write-up and no sign of the mirror work at all.
    Two pointers, because the page has two entry points: the attribution block at
    the top, which described only the Part 1 contribution, and a line under the
    Part 1 title for anyone scrolling. Part 2 already links back from its Credits,
    so the pair is navigable in both directions.
